physics-uwstout/lab-notebooks-saturated-absorption-spectroscopy/README.md

Open in Visual Studio Code (https://classroom.github.com/online_ide?assignment_repo_id=13879249&assignment_repo_type=AssignmentRepo)
