physics-uwstout/lab-notebooks-saturated-absorption-spectroscopy/Saturated Absorption Spectroscopy/Plechacek_Anthony/04_16_24.md

Did not take lab notes for this day. Worked on the PowerPoint for the poster for Research Day.
