physics-uwstout/lab-notebooks-saturated-absorption-spectroscopy/Saturated Absorption Spectroscopy/Plechacek_Anthony/Misc Files/SAS 04_03_24, Anthony Plechacek.pptx

## Saturated Absorption Spectroscopy

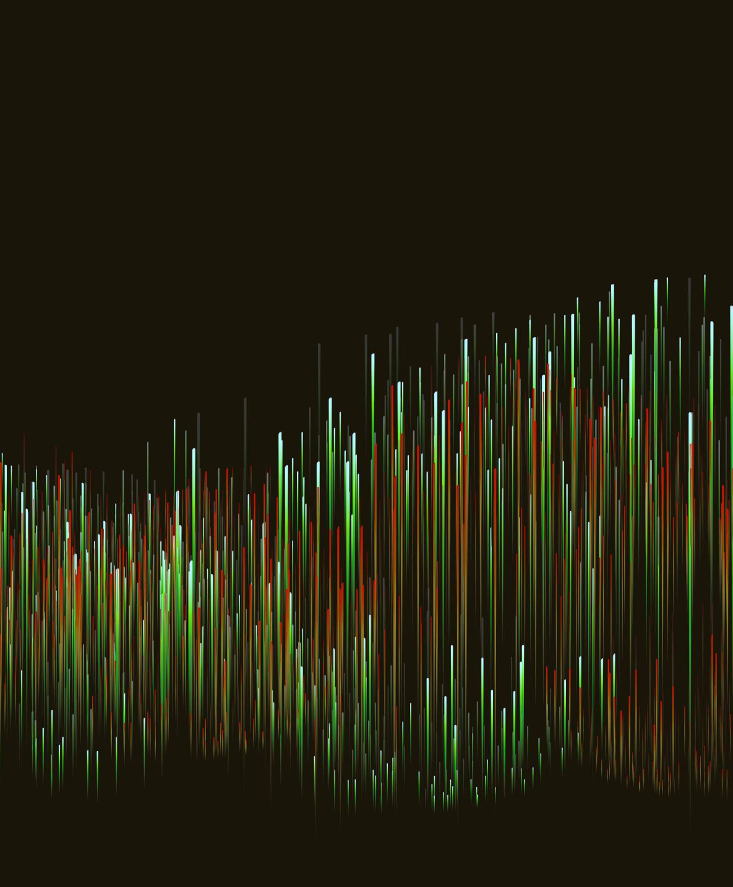
[picture p4: figure]

Anthony Plechacek
Luzando Mukubu

## Refresher

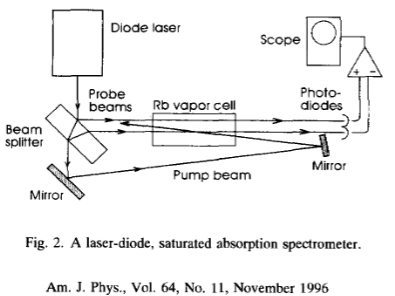
[picture p5: figure]

Why? Analysis of hyperfine structures of atoms.

## Experiment Update

- Aligned diffraction grating
- Spectrometer
- 3D printed external cavity diode laser

## Aligned Diffraction Grating

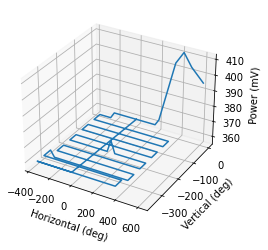
[picture p6: figure]
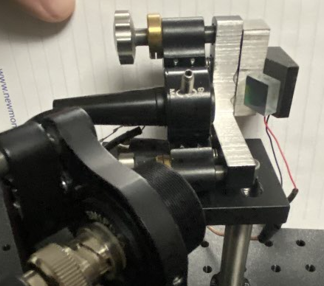
[picture p7: figure]

## Tragedy Strikes

## Diffraction Grating: Moving Forward

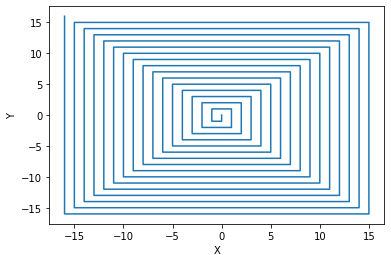
[picture p8: figure]

- Tighten Setup
- New Pattern

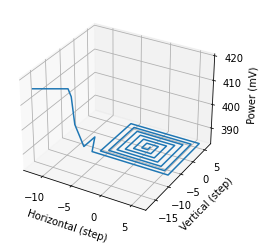
[picture p9: figure]

## Spectrometer

- 350 nm - 700 nm

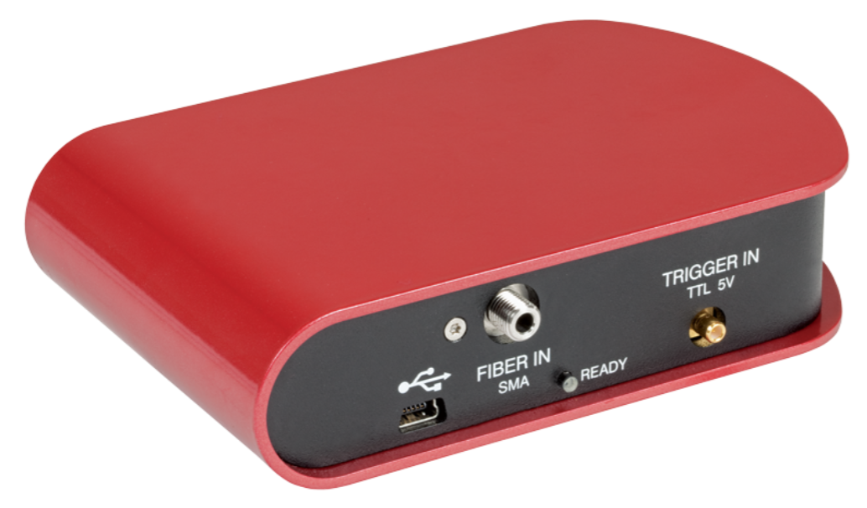
[picture p10: figure]
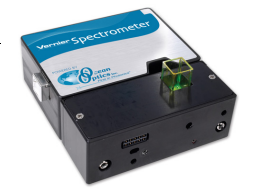
[picture p11: figure]

## Next Step

- Adjust Power input to laser
- Cooling laser shift modes

## 3D Printed External Cavity Diode Laser

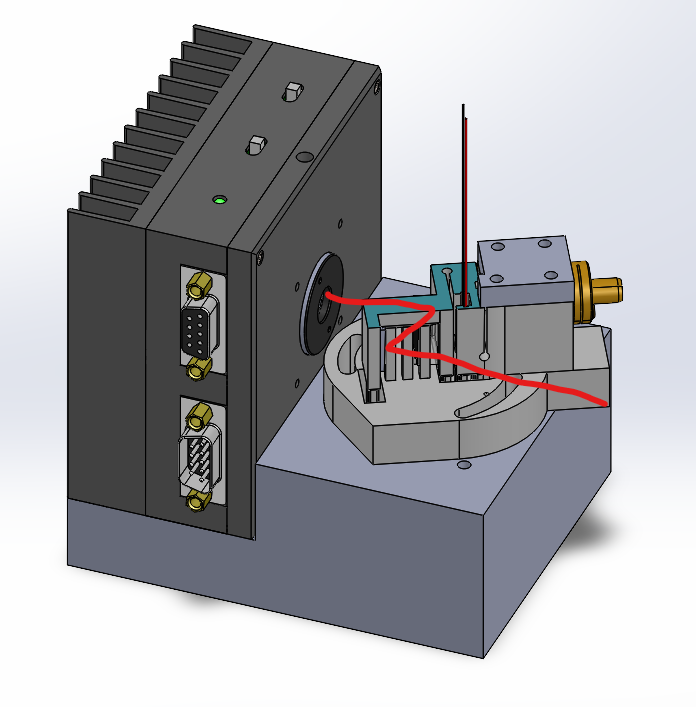
[picture p12: figure]

## Questions

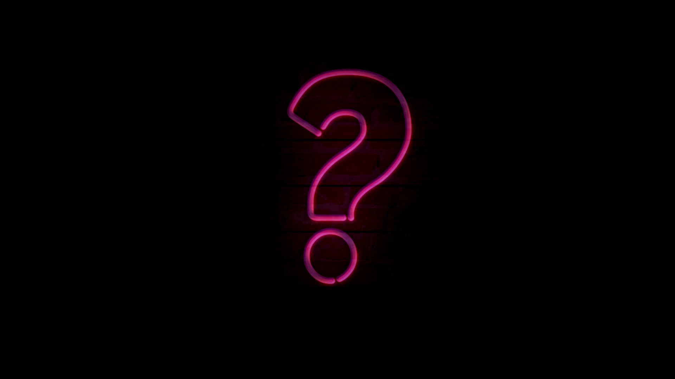
[picture p13: figure]
Neon Pink Question Mark
