physics-uwstout/lab-notebooks-saturated-absorption-spectroscopy/Saturated Absorption Spectroscopy/Plechacek_Anthony/Misc Files/SAS 02_29_24, Anthony Plechacek.pptx

## Saturated Absorption Spectroscopy

Anthony Plechacek and Luzando Mukubu

## Saturated Absorption Spectroscopy


## Experiment Update

- Setup
  - Mount diffraction grating
  - Hookup photodiode
  - Started aligning diffraction grating

## Diffraction Grating

- Reflect 1st Order Diffraction into Diode
- Reduces linewidth from 100MHz to 1MHz

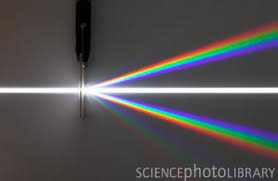
[picture p14: figure]
Lecture 29

## Diffraction Grating

- Diffraction Equation
  - 2asin(θ)=mλ
    - a: distance between slits (ridges)
    - θ : angle of diffraction
    - m: diffraction order
    - λ : wavelength of incident light
  - θ=28.0994°
    - a=8.33e−7 m
    - m=1
    - λ=785e−9 m

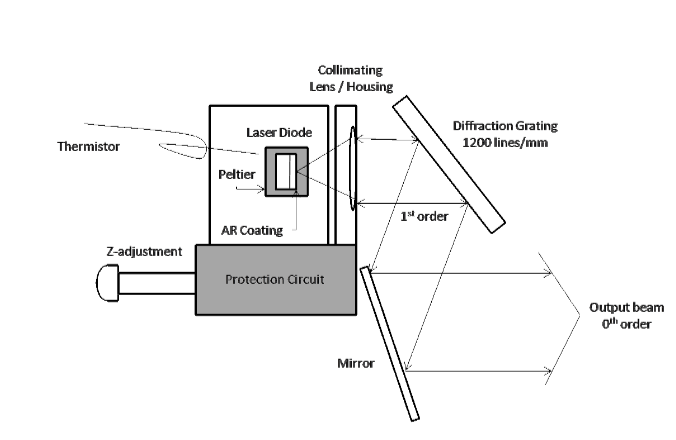
[picture p15: figure]

## Setup

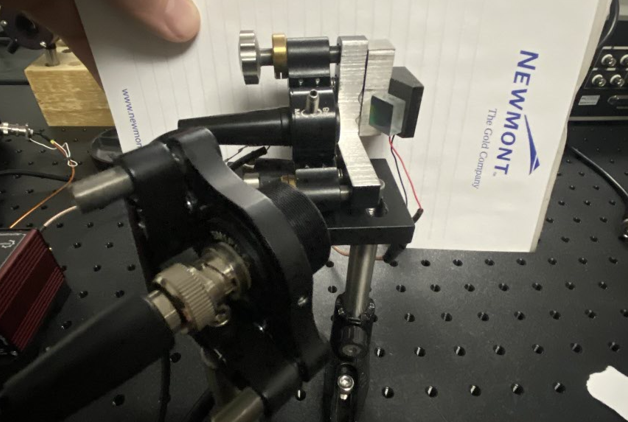
[picture p16: figure]

## Current Objectives

- Measure Saturated Absorption Spectroscopy of Rubidium
  - Tuning a diode laser
    - Medium Gain: through temperature
    - Internal Cavity: current and temperature
    - Grating Feedback: diffraction grating
    - External Cavity: piezoelectric motor
  - Setup Experiment
  - Collect Data

## Questions

Neon Pink Question Mark
