physics-uwstout/lab-notebooks-saturated-absorption-spectroscopy/Saturated Absorption Spectroscopy/Plechacek_Anthony/Misc Files/SAS 02_15_24, Anthony Plechacek.pptx

## Saturated Absorption Spectroscopy

Anthony Plechacek and Luzando Mukubu

## Doppler Broadening

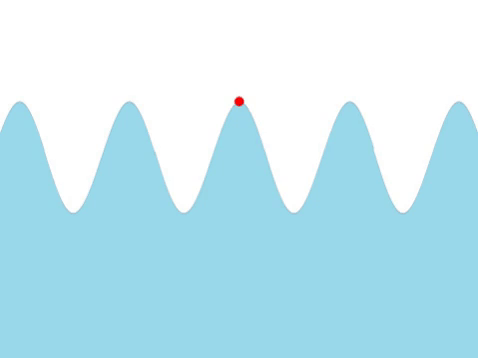
[picture p17: figure]
Water Wave - Key Stage Wiki

## Doppler Broadening Effect on Data

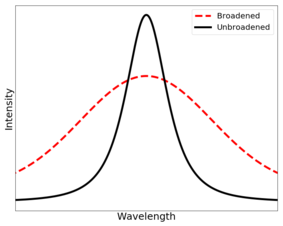
[picture p18: figure]

## What is Saturated Absorption Spectroscopy?


## Current Objectives

- Measure Saturated Absorption Spectroscopy of Rhubidium
  - Tuning a diode laser
    - Medium Gain: through temperature
    - Internal Cavity: current and temperature
    - Grating Feedback: diffraction grating
    - External Cavity: piezoelectric motor
  - Setup Experiment
  - Collect Data

## Questions

Neon Pink Question Mark
