physics-uwstout/lab-notebooks-saturated-absorption-spectroscopy/Saturated Absorption Spectroscopy/Plechacek_Anthony/Papers/Saturated absorption spectroscopy - Wikipedia.pdf

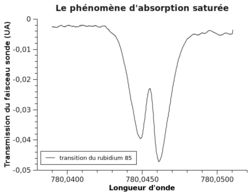
[picture p32: figure]

Typical transmission of the probe beam as recorded on the photodiode for natural rubidium as a function of the laser's wavelength

# Saturated absorption spectroscopy

Saturated absorption spectroscopy measures the transition frequency of an atom (https://en.wikipedia.org/wiki/Atom) or molecule (https://en.wikipedia.org/wiki/Molecule) between its ground state (https://en.wikipedia.org/wiki/Ground_state) and an excited state. (https://en.wikipedia.org/wiki/Excited_state) In saturated absorption spectroscopy, two counter-propagating, overlapped laser beams are sent through a sample of atomic gas. One of the beams stimulates photon emission in excited atoms or molecules when the laser's frequency matches the transition frequency. By changing the laser frequency until these extra photons appear, one can find the exact transition frequency. This method enables precise measurements at room temperature because it is insensitive to doppler broadening. (https://en.wikipedia.org/wiki/Doppler_broadening) Absorption spectroscopy (https://en.wikipedia.org/wiki/Absorption_spectroscopy) measures the doppler-broadened transition, so the atoms must be cooled to millikelvin temperatures to achieve the same sensitivity as saturated absorption spectroscopy.

To overcome the problem of Doppler broadening without cooling down the sample to millikelvin temperatures, a classical pump–probe scheme is used. A laser with a relatively high intensity is sent through the atomic vapor, known as the pump beam. Another counter-propagating weak beam is also sent through the atoms at the same frequency, known as the probe beam. The absorption of the probe beam is recorded on a photodiode for various frequencies of the beams.

Although the two beams are at the same frequency, they address different atoms due to natural thermal motion. (https://en.wikipedia.org/wiki/Thermal_motion) If the beams are red-detuned (https://en.wikipedia.org/wiki/Laser_detuning) with respect to the atomic transition frequency, then the pump beam will be absorbed by atoms moving towards the beam source, while the probe beam will be absorbed by atoms moving away from that source at the same speed in the opposite direction. If the beams are blue-detuned, the opposite occurs.

If, however, the laser is approximately on resonance, these
two beams address the same atoms, those with velocity
vectors nearly perpendicular to the direction of laser propagation. In the two-state approximation of an atomic transition, the strong pump beam will cause many of the atoms to be in the excited state; when the number of atoms in the ground state and the excited state are approximately equal, the transition is said to be saturated. When a photon from the probe beam passes through the atoms, there is a good chance that, if it encounters an atom, the atom will be in the excited state and will thus undergo stimulated emission, (https://en.wikipedia.org/wiki/Stimulated_emission) with the photon passing through the sample. Thus, as the laser frequency is swept across the resonance, a small dip in the absorption feature will be observed at each atomic transition (generally hyperfine resonances). (https://en.wikipedia.org/wiki/Hyperfine_structure) The stronger the
pump beam, the wider and deeper the dips in the Gaussian
Doppler-broadened absorption feature become. Under perfect
conditions, the width of the dip can approach the natural linewidth of the transition.[1]

## Principle of saturated absorption spectroscopy

A consequence of this method of counter-propagating beams on a system with more than two states is the presence of crossover lines. When two transitions are within a single Doppler-broadened feature and share a common ground state, a crossover peak at a frequency exactly between the two transitions can occur. This is the result of moving atoms seeing the pump and probe beams resonant with two separate transitions. The pump beam can cause the ground state to be depopulated, saturating one transition, while the probe beam finds much fewer atoms in the ground state because of this saturation, and its absorption falls. These crossover peaks can be quite strong, often stronger than the main saturated absorption peaks.[1]

According to the description of an atom interacting with the electromagnetic field, (https://en.wikipedia.org/wiki/Electromagnetic_field) the absorption of light by the atom depends on the frequency of the incident photons. More precisely, the absorption is characterized by a Lorentzian (https://en.wikipedia.org/wiki/Cauchy%E2%80%93Lorentz_distribution) of width Γ/2 (for reference, Γ ≈ 2π × 6 MHz for common rubidium (https://en.wikipedia.org/wiki/Rubidium) Dline transitions[2]
). If we have a cell of atomic vapour at room temperature, then the distribution of velocity will follow a Maxwell–Boltzmann distribution (https://en.wikipedia.org/wiki/Maxwell%E2%80%93Boltzmann_distribution)
where | is the number of atoms, | is the Boltzmann constant, (https://en.wikipedia.org/wiki/Boltzmann_constant) and | is the mass of the atom.
According to the Doppler effect (https://en.wikipedia.org/wiki/Doppler_effect) formula in the case of non-relativistic speeds,
where | is the frequency of the atomic transition when the atom is at rest (the one which is being
probed). The value of as a function of | and | can be inserted in the distribution of velocities.
The distribution of absorption as a function of the pulsation will therefore be proportional to a Gaussian with full width at half maximum (https://en.wikipedia.org/wiki/Full_width_at_half_maximum)

For a rubidium atom at room temperature,[3]

Therefore, without any special trick in the experimental setup probing the maximum of absorption of an atomic vapour, the uncertainty of the measurement will be limited by the Doppler broadening and not by the fundamental width of the resonance.

As the pump and the probe beam must have the same exact frequency, the most convenient solution is for them to come from the same laser. The probe beam can be made of a reflection of the pump beam passed through neutral density filter to reduce its intensity. To fine-tune the frequency of the laser, a

## Doppler broadening of the absorption spectrum of an atom

## Experimental realization

diode laser with a piezoelectric transducer (https://en.wikipedia.org/wiki/Piezoelectric_transducer) that controls the cavity wavelength can be used. Due to photodiode noise, the laser frequency can be swept across the transition and the photodiode reading averaged over many sweeps.

In real atoms, there are sometimes more than two relevant transitions within the sample's Doppler profile (e.g. in alkali atoms with hyperfine interactions). (https://en.wikipedia.org/wiki/Hyperfine_structure) This will generate the apparition of other dips in the absorption feature due to these new resonances in addition to crossover resonances.

Saturated Absorption Spectroscopy of Rubidium (http://www.phys.ufl.edu/courses/phy4803L/group_III/sat_absorbtion/SatAbs.pdf) (http://www.phys.ufl.edu/courses/phy4803L/group_III/sat_absorbtion/SatAbs.pdf)

1. Daryl W. Preston (November 1996). "Doppler-free saturated absorption: Laser spectroscopy" (htt p://academic.reed.edu/physics/courses/Physics332.s10/pdf/Doppler_Free.pdf) (PDF). American Journal of Physics. 64 (11): 1432–1436. Bibcode: (https://en.wikipedia.org/wiki/Bibcode_(identifier))1996AmJPh..64.1432P (https://ui.adsabs.harvard.edu/abs/1996AmJPh..64.1432P). (https://ui.adsabs.harvard.edu/abs/1996AmJPh..64.1432P) doi: (https://en.wikipedia.org/wiki/Doi_(identifier))10.1119/1.18457 (https://doi.org/10.1119%2F1.18457).
2. D. A. Steck. "Alkali D line Data" (http://steck.us/alkalidata/).
3. Chris Leahy, J. Todd Hastings, and P. M. Wilt, Temperature dependence of Doppler-broadening in rubidium: An undergraduate experiment, American Journal of Physics 65, 367 (1997); https://doi.org/10.1119/1.18553.

Retrieved from "https://en.wikipedia.org/w/index.php?title=Saturated_absorption_spectroscopy&oldid=1175440175"

## References
