physics-uwstout/lab-notebooks-saturated-absorption-spectroscopy/Saturated Absorption Spectroscopy/Plechacek_Anthony/Analysis/Book1.xlsx

Current (mA) | Output (mV)
34.0 | 376
34.1 | 380
34.2 | 384
34.3 | 388
34.4 | 392
34.5 | 396
34.6 | 396
34.7 | 400
34.8 | 400
34.9 | 404
35.0 | 404
35.1 | 404
35.2 | 408
35.3 | 412
35.4 | 412
35.5 | 416
35.6 | 416
35.7 | 416
35.8 | 420
35.9 | 420
36.0 | 424
33.8 | 364
33.3 | 352
32.8 | 344
32.2 | 340
31.9 | 336
31.1 | 332
