physics-uwstout/lab-notebooks-saturated-absorption-spectroscopy/Saturated Absorption Spectroscopy/Plechacek_Anthony/Analysis/Diffraction Grating Alignment Notes.pdf

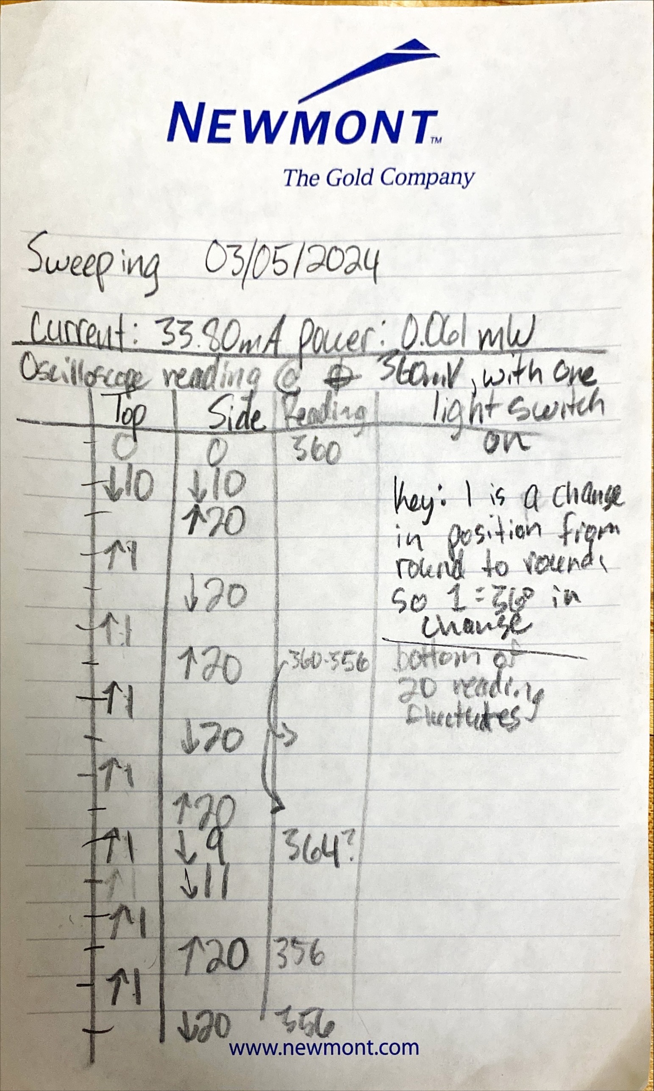
[picture p33: page 1]
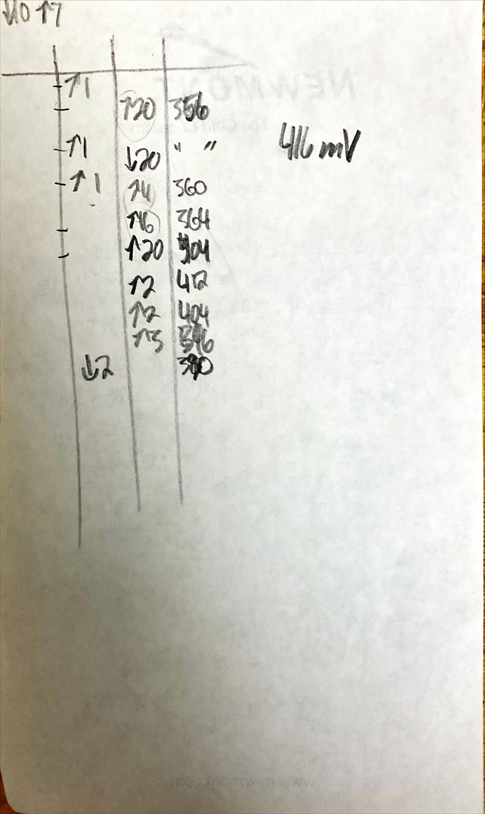
[picture p34: page 2]
