physics-uwstout/lab-notebooks-saturated-absorption-spectroscopy/Saturated Absorption Spectroscopy/Plechacek_Anthony/Manual/L785P25-SpecSheet.pdf

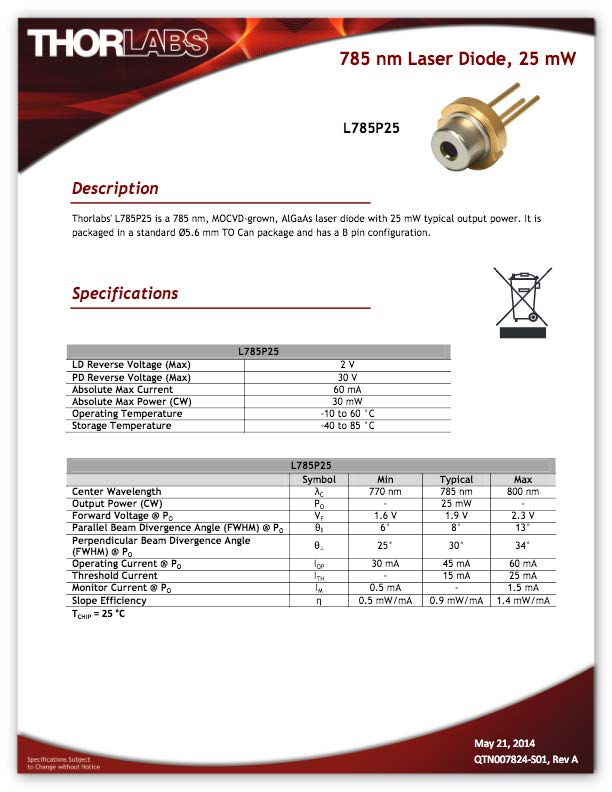
[picture p35: page 1]
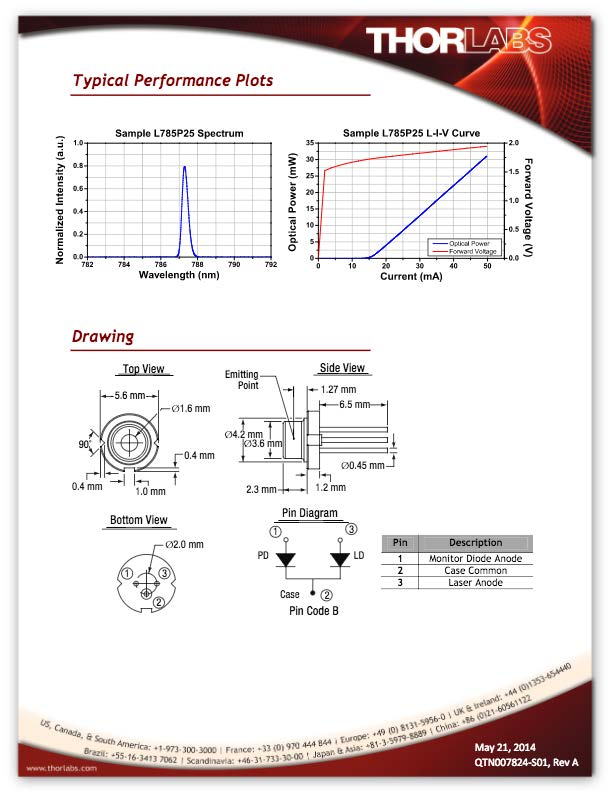
[picture p36: page 2]
