physics-uwstout/lab-notebooks-saturated-absorption-spectroscopy/Saturated Absorption Spectroscopy/Plechacek_Anthony/Analysis/Diffraction 03_21_24.xlsx

X | Y | Power | Current
0 | 0 | 384 | 35 mA
0 | -1 | 384
-1 | -1 | 384
-1 | 0 | 384
-1 | 1 | 384
0 | 1 | 384
1 | 1 | 384
1 | 0 | 384
1 | -1 | 384
1 | -2 | 384
0 | -2 | 384
-1 | -2 | 384
-2 | -2 | 384
-2 | -1 | 384
-2 | 0 | 384
-2 | 1 | 384
-2 | 2 | 384
-1 | 2 | 384
0 | 2 | 384
1 | 2 | 384
2 | 2 | 384
2 | 1 | 384
2 | 0 | 384
2 | -1 | 384
2 | -2 | 384
2 | -3 | 384
1 | -3 | 384
0 | -3 | 384
-1 | -3 | 384
-2 | -3 | 384
-3 | -3 | 384
-3 | -2 | 384
-3 | -1 | 384
-3 | 0 | 384
-3 | 1 | 384
-3 | 2 | 384
-3 | 3 | 384
-2 | 3 | 384
-1 | 3 | 384
0 | 3 | 384
1 | 3 | 384
2 | 3 | 384
3 | 3 | 384
3 | 2 | 384
3 | 1 | 384
3 | 0 | 384
3 | -1 | 384
3 | -2 | 384
3 | -3 | 384
3 | -4 | 384
2 | -4 | 384
1 | -4 | 384
0 | -4 | 384
-1 | -4 | 384
-2 | -4 | 384
-3 | -4 | 384
-4 | -4 | 384
-4 | -3 | 384
-4 | -2 | 384
-4 | -1 | 384
-4 | 0 | 384
-4 | 1 | 384
-4 | 2 | 384
-4 | 3 | 384
-4 | 4 | 384
-3 | 4 | 384
-2 | 4 | 384
-1 | 4 | 384
0 | 4 | 384
1 | 4 | 384
2 | 4 | 384
3 | 4 | 384
4 | 4 | 384
4 | 3 | 384
4 | 2 | 384
4 | 1 | 384
4 | 0 | 384
4 | -1 | 384
4 | -2 | 384
4 | -3 | 384
4 | -4 | 384
4 | -5 | 384
3 | -5 | 384
2 | -5 | 384
1 | -5 | 384
0 | -5 | 384
-1 | -5 | 384
-2 | -5 | 384
-3 | -5 | 384
-4 | -5 | 384
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
