physics-uwstout/lab-notebooks-saturated-absorption-spectroscopy/Saturated Absorption Spectroscopy/Plechacek_Anthony/Analysis/Diffraction Grating Data.xlsx

Sheet: Sheet1
Vertical (deg) | Horizontal (deg) | Power (mV) | Input Current (mA) | Input Power (mW)
0 | 0 | 360 | 33.8 | 0.061
-360 | -36 | 360
-360 | -72 | 360
-360 | -108 | 360
-360 | -144 | 360
-360 | -180 | 360
-360 | -216 | 360
-360 | -252 | 360
-360 | -288 | 360
-360 | -324 | 360
-360 | -360 | 360
-360 | 36 | 360
-360 | 72 | 360
-360 | 108 | 360
-360 | 144 | 360
-360 | 180 | 360
-360 | 216 | 360
-360 | 252 | 360
-360 | 288 | 360
-360 | 324 | 360
-360 | 360 | 360
-324 | 360 | 360
-324 | 324 | 360
-324 | 288 | 360
-324 | 252 | 360
-324 | 216 | 360
-324 | 180 | 360
-324 | 144 | 360
-324 | 108 | 360
-324 | 72 | 360
-324 | 36 | 360
-324 | 0 | 360
-324 | -36 | 360
-324 | -72 | 360
-324 | -108 | 360
-324 | -144 | 360
-324 | -180 | 360
-324 | -216 | 360
-324 | -252 | 360
-324 | -288 | 360
-324 | -324 | 360
-324 | -360 | 360
-288 | -360 | 360
-288 | -324 | 356
-288 | -288 | 356
-288 | -252 | 356
-288 | -216 | 356
-288 | -180 | 356
-288 | -144 | 356
-288 | -108 | 356
-288 | -72 | 356
-288 | -36 | 356
-288 | 0 | 356
-288 | 36 | 356
-288 | 72 | 356
-288 | 108 | 356
-288 | 144 | 356
-288 | 180 | 356
-288 | 216 | 356
-288 | 252 | 356
-288 | 288 | 356
-288 | 324 | 356
-288 | 360 | 356
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
