physics-uwstout/lab-notebooks-saturated-absorption-spectroscopy/Saturated Absorption Spectroscopy/Plechacek_Anthony/Misc Files/20240411_141443904_iOS.jpg

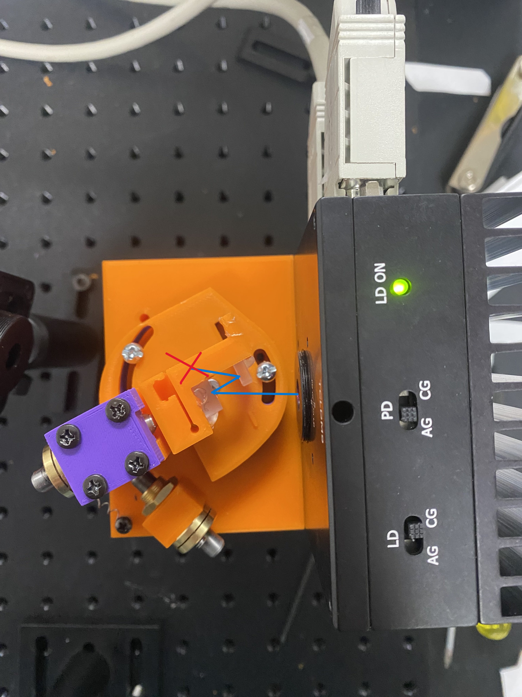
Saturated Absorption Spectroscopy/Plechacek_Anthony/Misc Files/20240411_141443904_iOS.jpg
