physics-uwstout/lab-notebooks-saturated-absorption-spectroscopy/Saturated Absorption Spectroscopy/Plechacek_Anthony/Misc Files/Pasted image 20240404103153.png

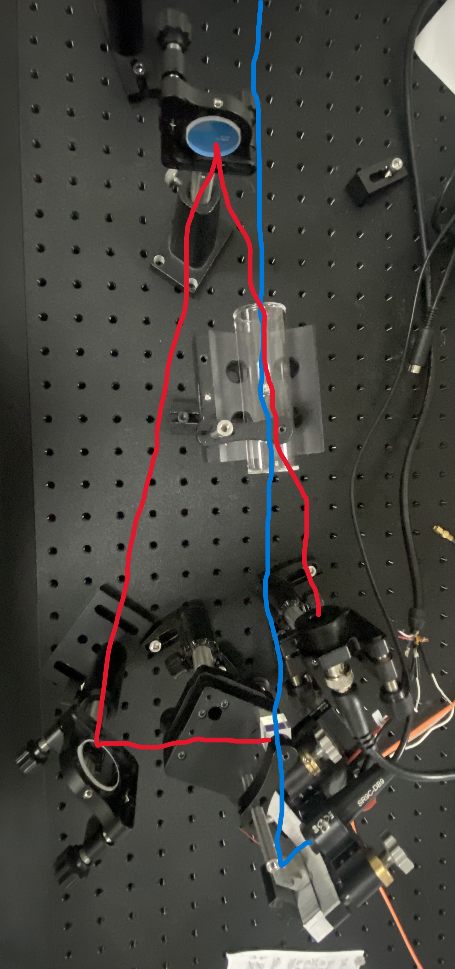
Saturated Absorption Spectroscopy/Plechacek_Anthony/Misc Files/Pasted image 20240404103153.png
