physics-uwstout/lab-notebooks-saturated-absorption-spectroscopy/Saturated Absorption Spectroscopy/Plechacek_Anthony/Misc Files/3D Print Supplement/3D Print.3mf

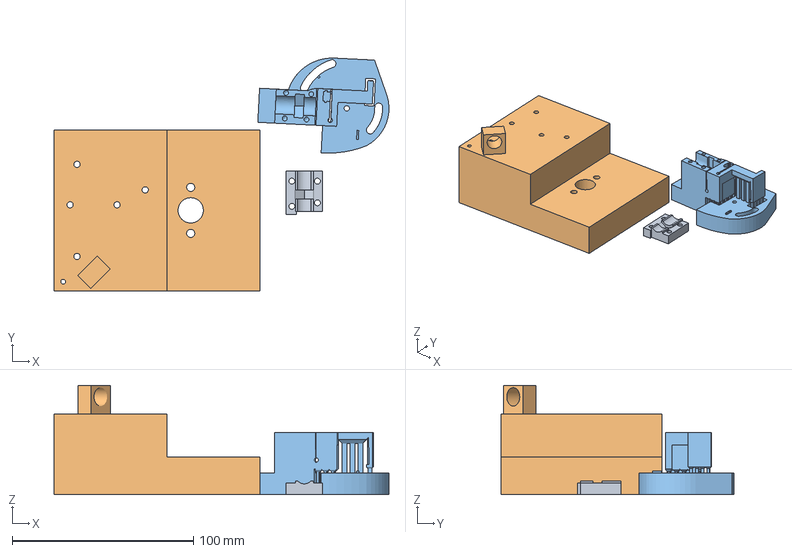
[picture p39: CAD file, 2024-04-02]
Saturated Absorption Spectroscopy/Plechacek_Anthony/Misc Files/3D Print Supplement/3D Print.3mf
184.9 x 128.5 x 60.3 mm
New Cap.STL
New Laser Base.STL
New Grating Base.STL
