physics-uwstout/lab-notebooks-saturated-absorption-spectroscopy/Saturated Absorption Spectroscopy/Plechacek_Anthony/Analysis/Diffraction Data Test 2.xlsx

X | Y
0 | 0
0 | -1
-1 | -1
-1 | 0
-1 | 1
0 | 1
1 | 1
1 | 0
1 | -1
1 | -2
0 | -2
-1 | -2
-2 | -2
-2 | -1
-2 | 0
-2 | 1
-2 | 2
-1 | 2
0 | 2
1 | 2
2 | 2
2 | 1
2 | 0
2 | -1
2 | -2
2 | -3
1 | -3
0 | -3
-1 | -3
-2 | -3
-3 | -3
-3 | -2
-3 | -1
-3 | 0
-3 | 1
-3 | 2
-3 | 3
-2 | 3
-1 | 3
0 | 3
1 | 3
2 | 3
3 | 3
3 | 2
3 | 1
3 | 0
3 | -1
3 | -2
3 | -3
3 | -4
2 | -4
1 | -4
0 | -4
-1 | -4
-2 | -4
-3 | -4
-4 | -4
-4 | -3
-4 | -2
-4 | -1
-4 | 0
-4 | 1
-4 | 2
-4 | 3
-4 | 4
-3 | 4
-2 | 4
-1 | 4
0 | 4
1 | 4
2 | 4
3 | 4
4 | 4
4 | 3
4 | 2
4 | 1
4 | 0
4 | -1
4 | -2
4 | -3
4 | -4
4 | -5
3 | -5
2 | -5
1 | -5
0 | -5
-1 | -5
-2 | -5
-3 | -5
-4 | -5
-5 | -5
-5 | -4
-5 | -3
-5 | -2
-5 | -1
-5 | 0
-5 | 1
-5 | 2
-5 | 3
-5 | 4
-5 | 5
-4 | 5
-3 | 5
-2 | 5
-1 | 5
0 | 5
1 | 5
2 | 5
3 | 5
4 | 5
5 | 5
5 | 4
5 | 3
5 | 2
5 | 1
5 | 0
5 | -1
5 | -2
5 | -3
5 | -4
5 | -5
5 | -6
4 | -6
3 | -6
2 | -6
1 | -6
0 | -6
-1 | -6
-2 | -6
-3 | -6
-4 | -6
-5 | -6
-6 | -6
-6 | -5
-6 | -4
-6 | -3
-6 | -2
-6 | -1
-6 | 0
-6 | 1
-6 | 2
-6 | 3
-6 | 4
-6 | 5
-6 | 6
-5 | 6
-4 | 6
-3 | 6
-2 | 6
-1 | 6
0 | 6
1 | 6
2 | 6
3 | 6
4 | 6
5 | 6
6 | 6
6 | 5
6 | 4
6 | 3
6 | 2
6 | 1
6 | 0
6 | -1
6 | -2
6 | -3
6 | -4
6 | -5
6 | -6
6 | -7
5 | -7
4 | -7
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
