physics-uwstout/lab-notebooks-saturated-absorption-spectroscopy/Saturated Absorption Spectroscopy/Plechacek_Anthony/Analysis/Diffraction Data Test2.xlsx

Horizontal | Vertical | Power
0 | 0 | 356
0 | -1 | 356
-1 | -1 | 356
-1 | 0 | 356
-1 | 1 | 356
0 | 1 | 356
1 | 1 | 356
1 | 0 | 356
1 | -1 | 356
1 | -2 | 356
0 | -2 | 356
-1 | -2 | 356
-2 | -2 | 356
-2 | -1 | 356
-2 | 0 | 356
-2 | 1 | 356
-2 | 2 | 356
-1 | 2 | 356
0 | 2 | 356
1 | 2 | 356
2 | 2 | 356
2 | 1 | 352
2 | 0 | 352
2 | -1 | 352
2 | -2 | 352
2 | -3 | 352
1 | -3 | 352
0 | -3 | 352
-1 | -3 | 352
-2 | -3 | 352
-3 | -3 | 352
-3 | -2 | 352
-3 | -1 | 352
-3 | 0 | 352
-3 | 1 | 352
-3 | 2 | 352
-3 | 3 | 352
-2 | 3 | 352
-1 | 3 | 352
0 | 3 | 352
1 | 3 | 352
2 | 3 | 352
3 | 3 | 352
3 | 2 | 352
3 | 1 | 352
3 | 0 | 352
3 | -1 | 352
3 | -2 | 352
3 | -3 | 352
3 | -4 | 352
2 | -4 | 352
1 | -4 | 352
0 | -4 | 352
-1 | -4 | 352
-2 | -4 | 352
-3 | -4 | 352
-4 | -4 | 344
-4 | -3 | 352
-4 | -2 | 352
-4 | -1 | 352
-4 | 0 | 352
-4 | 1 | 352
-4 | 2 | 352
-4 | 3 | 352
-4 | 4 | 352
-3 | 4 | 352
-2 | 4 | 352
-1 | 4 | 352
0 | 4 | 352
1 | 4 | 352
2 | 4 | 352
3 | 4 | 352
4 | 4 | 352
4 | 3 | 352
4 | 2 | 352
4 | 1 | 352
4 | 0 | 352
4 | -1 | 352
4 | -2 | 352
4 | -3 | 352
4 | -4 | 352
4 | -5 | 348
3 | -5 | 352
2 | -5 | 352
1 | -5 | 352
0 | -5 | 352
-1 | -5 | 352
-2 | -5 | 352
-3 | -5 | 352
-4 | -5 | 352
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
