physics-uwstout/lab-notebooks-saturated-absorption-spectroscopy/(commit log)

2024-02-27 Lab 02/27/24 Notes
    [Book1.xlsx]
2024-02-29 Renamed PDF's, Created PowerPoint
2024-03-05 March 5th, 2024 Lab Notes
    IMPORTANT Progress!!!
    [AD15NT-Step.step, Diffraction Grating Data.xlsx, LT230P-B-Step.step, ScrewMount.ipt, ScrewMount.stl, adjustment_screw_cap.ipt, adjustment_screw_cap.stl, allignment_plate.ipt]
2024-03-07 extra files that were not uploading
    [AD15NT-Step.SLDPRT, AD15NT-Step.step, LT230P-B-Step.SLDPRT, LT230P-B-Step.step, ScrewMount.SLDPRT, ScrewMount.ipt, ScrewMount.stl, Unknown.SLDPRT]
2024-03-21 data and analysis
    [Diffraction Data Test 2.xlsx, Diffraction Data Test2.xlsx, Diffraction Grating Data.xlsx]
2024-04-02 Notes and Cad
    Cad files and notes from the previous few classes
    [03_21_24, Spectrum Aligned 1.csv, 03_21_24, Spectrum Aligned 2.csv, 3D Print.3mf, AD15NT-Step.SLDPRT, AD15NT-Step.step, Book1.xlsx, Diffraction 03_21_24.xlsx, Diffraction Data Test 2.xlsx]
2024-04-30 Final GitHub submission
    [Diffraction Data Test 2.xlsx]
